SrikarBharadwajR/Project-Tachometer/README.md

# Project-Tachometer
Instrument which is used for measuring rotations per minute of a rotating object.
