SrikarBharadwajR/Project-Tachometer/BOM with Price.ods

Sl. No. | Name | Quantity | Price | Link | Distributor Part Number
1 | PCB Printing
2 | 1.3” OLED Display | 1 | 367 | https://robu.in/product/1-3-inch-i2c-iic-oled-4-pin-lcd-module-4pin-with-vcc-gnd-blue/ | 617729
3 | IR Emitter and Receiver LEDs | 1 | - | - | -
4 | 10k Trimmer Potentiometer | 1 | 89 | https://robu.in/product/3296w-10k-ohm-trimpot-trimmer-potentiometer-pack-of-5/ | 611196
5 | 100R resistor | 1 | 1 | - | -
6 | Male and Female Headers | - | - | - | -
7 | 1uF Capacitor | 4 | 23.25 | https://www.digikey.in/en/products/detail/murata-electronics/GCG21BR71H105KA01L/16033470 | 490-GCG21BR71H105KA01LCT-ND
8 | 10uF Capacitor | 3 | 18.26 | https://www.digikey.in/en/products/detail/murata-electronics/GRM21BR61E106KA73L/2334874 | 490-5523-1-ND
9 | 0.1uF Capacitor | 6 | 19.92 | https://www.digikey.in/en/products/detail/murata-electronics/GCJ21BR72A104KA01K/11618560 | 490-GCJ21BR72A104KA01KCT-ND
10 | 33pF Capacitor | 2 | 71.4 | https://www.digikey.in/en/products/detail/murata-electronics/GQM2195C2E330FB12D/11618474 | 490-GQM2195C2E330FB12DCT-ND
11 | 10k Resistor | 6 | 11.62 | https://www.digikey.in/en/products/detail/rohm-semiconductor/ESR03EZPF1002/1983429 | RHM10KADCT-ND
12 | 1.5k Resistor | 3 | 11.62 | https://www.digikey.in/en/products/detail/rohm-semiconductor/ESR03EZPF1501/1983433 | RHM1.50KADCT-ND
13 | 500R Resistor | 1 | 10.79 | https://www.digikey.in/en/products/detail/rohm-semiconductor/ESR03EZPJ511/1762734 | RHM510DCT-ND
14 | 0R Resistor | 1 | 8.3 | https://www.digikey.in/en/products/detail/rohm-semiconductor/SFR03EZPJ000/9771856 | 511-1823-1-ND
15 | STM32F103C8T6 | 1 | 532.99 | https://www.digikey.in/en/products/detail/stmicroelectronics/STM32F103C8T6TR/2122442 | 497-17666-1-ND
16 | Slide Switch | 1 | 88.83 | https://www.digikey.in/en/products/detail/c-k/PCM12SMTR/1640112 | 401-2016-1-ND
17 | OP-Amp LMV321WG | 1 | 40.68 | https://www.digikey.in/en/products/detail/diodes-incorporated/LMV321WG-7/2182582 | LMV321WG-7DICT-ND
18 | Indication Yellow LED | 1 | 25.74 | https://www.digikey.in/en/products/detail/dialight/5988070107F/1291269 | 350-2035-1-ND
19 | AMS1117 3.3v regulator | 1 | 31.55 | https://www.digikey.in/en/products/detail/diodes-incorporated/AZ1117H-3-3TRE1/4471000 | AZ1117H-3.3TRE1DICT-ND
20 | Crystal Oscillator | 1 | 32.38 | https://www.digikey.in/en/products/detail/fox-electronics/FC4SDCBMF8-0-T1/1024602 | 631-1010-1-ND
21 | Toggle Switch | 3 | 19.92 | https://www.digikey.in/en/products/detail/cui-devices/TS09-63-25-WT-160-SMT-TR/15839066 | 2223-TS09-63-25-WT-160-SMT-TRCT-ND
22 | 120R Ferrite Bead | 1 | 15.77 | https://www.digikey.in/en/products/detail/laird-signal-integrity-products/MI0603M121R-10/806614 | 240-2375-1-ND
23 | Micro USB | 1 | 58.11 | https://www.digikey.in/en/products/detail/gct/USB3076-30-A/9859635 | 2073-USB3076-30-ACT-ND
 | TOTAL AMOUNT (in Rs.) = |  | 1876.58
