SrikarBharadwajR/Project-Tachometer/PCB Design/Tachometer/Tachometer.kicad_pcb

## KiCad design PCB Design/Tachometer/Tachometer.kicad_pcb (2023-09-17)

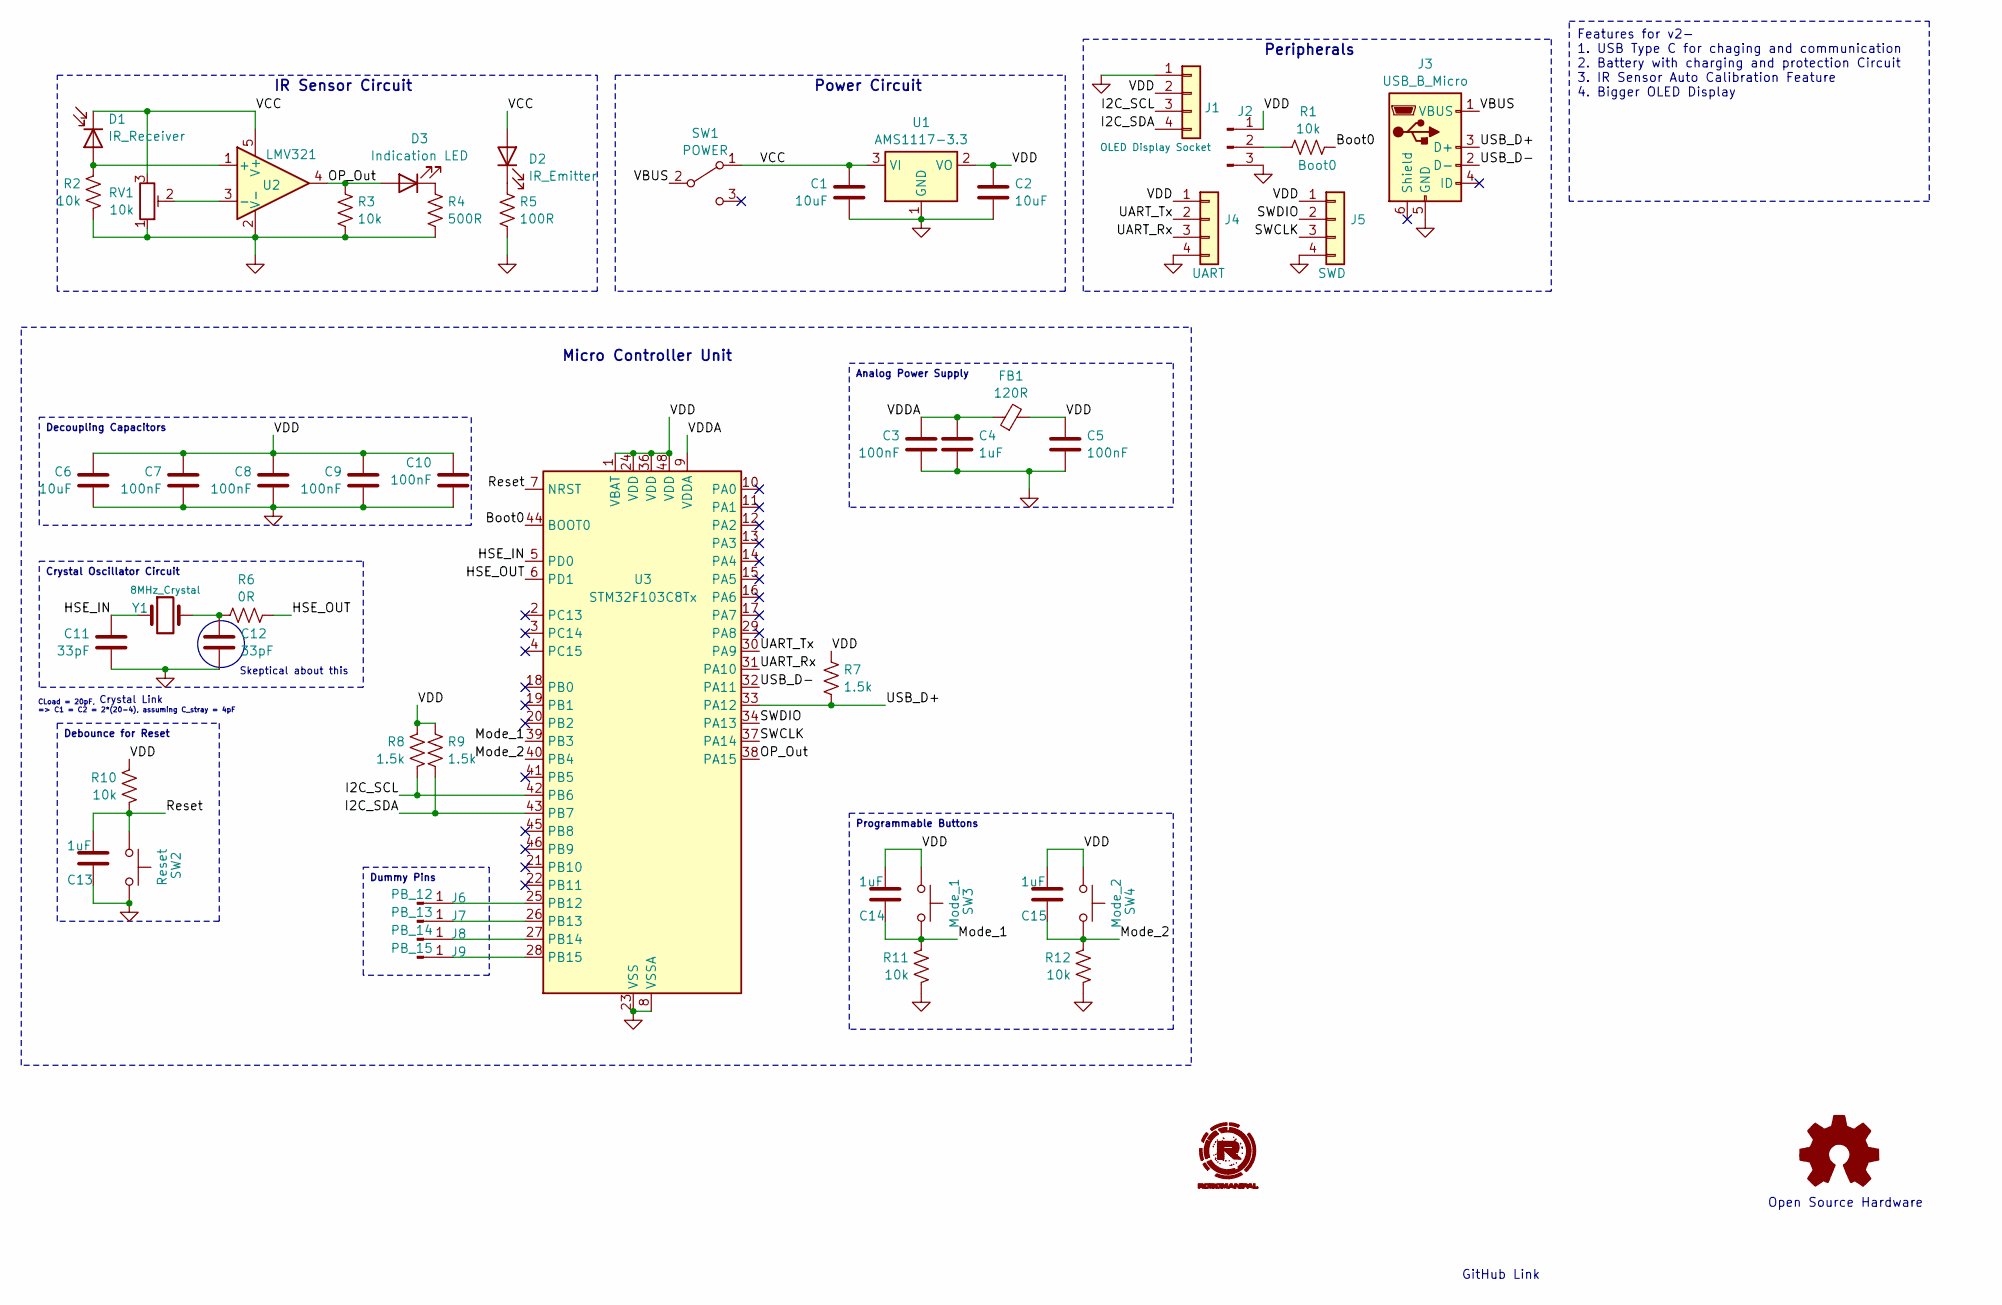
[picture p1: schematic Tachometer.kicad_sch, Project Tachometer]

Parts:
C1, C2, C6: 10uF; C_0805_2012Metric_Pad1.18x1.45mm_HandSolder
C3, C5, C7, C8, C9, C10: 100nF; C_0805_2012Metric_Pad1.18x1.45mm_HandSolder
C4, C13, C14, C15: 1uF; C_0805_2012Metric_Pad1.18x1.45mm_HandSolder
C11, C12: 33pF; C_0805_2012Metric_Pad1.18x1.45mm_HandSolder
D1: IR_Receiver; LED_5mm_Radial
D2: IR_Emitter; LED_5mm_Radial
D3: Indication LED; LED_0603_1608Metric_Pad1.05x0.95mm_HandSolder
FB1: 120R; L_0603_1608Metric_Pad1.05x0.95mm_HandSolder
J1: OLED Display Socket; PinSocket_1x04_P2.54mm_Vertical
J2: Boot0; PinHeader_1x03_P2.54mm_Vertical
J3: USB_B_Micro; USB_Micro-B_GCT_USB3076-30-A
J4: UART; PinHeader_1x04_P2.54mm_Vertical
J5: SWD; PinHeader_1x04_P2.54mm_Vertical
J6: PB_12; SolderWirePad_1x01_SMD_1x2mm
J7: PB_13; SolderWirePad_1x01_SMD_1x2mm
J8: PB_14; SolderWirePad_1x01_SMD_1x2mm
J9: PB_15; SolderWirePad_1x01_SMD_1x2mm
R1, R2, R3, R10, R11, R12: 10k; R_0603_1608Metric_Pad0.98x0.95mm_HandSolder
R4: 500R; R_0603_1608Metric_Pad0.98x0.95mm_HandSolder
R5: 100R; R_Axial_DIN0204_L3.6mm_D1.6mm_P5.08mm_Horizontal
R6: 0R; R_0603_1608Metric_Pad0.98x0.95mm_HandSolder
R7, R8, R9: 1.5k; R_0603_1608Metric_Pad0.98x0.95mm_HandSolder
RV1: 10k; Potentiometer_Bourns_3296W_Vertical
SW1: POWER; SW_SPDT_PCM12
SW2: Reset; SW_TS09-63-25-WT-160-SMT-TR
SW3: Mode_1; SW_TS09-63-25-WT-160-SMT-TR
SW4: Mode_2; SW_TS09-63-25-WT-160-SMT-TR
U1: AMS1117-3.3; SOT-223-3_TabPin2
U2: LMV321; SOT25
U3: STM32F103C8Tx; LQFP-48_7x7mm_P0.5mm
Y1: 8MHz_Crystal; Crystal_SMD_HC49-SD

Connections:
/Boot0: R1.2, U3.44 (BOOT0)
/HSE_IN: C11.1, U3.5 (PD0), Y1.1
/HSE_OUT: R6.2, U3.6 (PD1)
/I2C_SCL: J1.3, R8.1, U3.42 (PB6)
/I2C_SDA: J1.4, R9.1, U3.43 (PB7)
/Mode_1: C14.1, R11.2, SW3.2, U3.39 (PB3)
/Mode_2: C15.1, R12.2, SW4.2, U3.40 (PB4)
/OP_Out: D3.2 (A), R3.1, U2.4, U3.38 (PA15)
/Reset: C13.2, R10.1, SW2.1, U3.7 (NRST)
/SWCLK: J5.3, U3.37 (PA14)
/SWDIO: J5.2, U3.34 (PA13)
/UART_Rx: J4.3, U3.31 (PA10)
/UART_Tx: J4.2, U3.30 (PA9)
/USB_D+: J3.3 (D+), R7.1, U3.33 (PA12)
/USB_D-: J3.2 (D-), U3.32 (PA11)
/VBUS: J3.1 (VBUS), SW1.2 (B)
/VCC: C1.1, D1.1 (K), D2.2 (A), RV1.3, SW1.1 (A), U1.3 (VI), U2.5 (V+)
/VDD: C2.1, C5.1, C6.1, C7.1, C8.1, C9.1, C10.1, C14.2, C15.2, FB1.2, J1.2, J2.1, J4.1, J5.1, R7.2, R8.2, R9.2, R10.2, SW3.1, SW4.1, U1.2 (VO), U3.1 (VBAT), U3.24 (VDD), U3.36 (VDD), U3.48 (VDD)
/VDDA: C3.1, C4.1, FB1.1, U3.9 (VDDA)
GND: C1.2, C2.2, C3.2, C4.2, C5.2, C6.2, C7.2, C8.2, C9.2, C10.2, C11.2, C12.2, C13.1, J1.1, J2.3, J3.5 (GND), J4.4, J5.4, R2.2, R3.2, R4.2, R5.2, R11.1, R12.1, RV1.1, SW2.2, U1.1 (GND), U2.2 (V-), U3.8 (VSSA), U3.23 (VSS), U3.35 (VSS), U3.47 (VSS)
unnamed: C12.1, R6.1, Y1.2
unnamed: D1.2 (A), R2.1, U2.1 (+)
unnamed: D2.1 (K), R5.1
unnamed: D3.1 (K), R4.1
unnamed: J2.2, R1.1
unnamed: J6.1, U3.25 (PB12)
unnamed: J7.1, U3.26 (PB13)
unnamed: J8.1, U3.27 (PB14)
unnamed: J9.1, U3.28 (PB15)
unnamed: RV1.2, U2.3 (-)

Notes on the sheet:
Analog Power Supply
Decoupling Capacitors
Crystal Oscillator Circuit
Dummy Pins
Programmable Buttons
Debounce for Reset
Features for v2- 1. USB Type C for chaging and communication 2. Battery with charging and protection Circuit 3. IR Sensor Auto Calibration Feature 4. Bigger OLED Display
Peripherals
Skeptical about this
Power Circuit
CLoad = 20pF, => C1 = C2 = 2*(20-4), assuming C_stray = 4pF
Micro Controller Unit
GitHub Link
Crystal Link
Open Source Hardware
IR Sensor Circuit

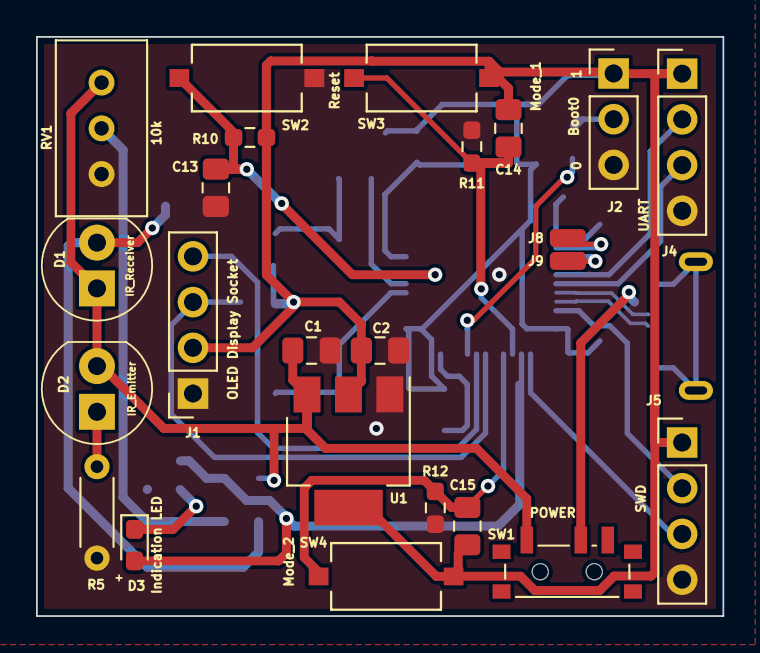
[picture p2: board Tachometer.kicad_pcb from above]

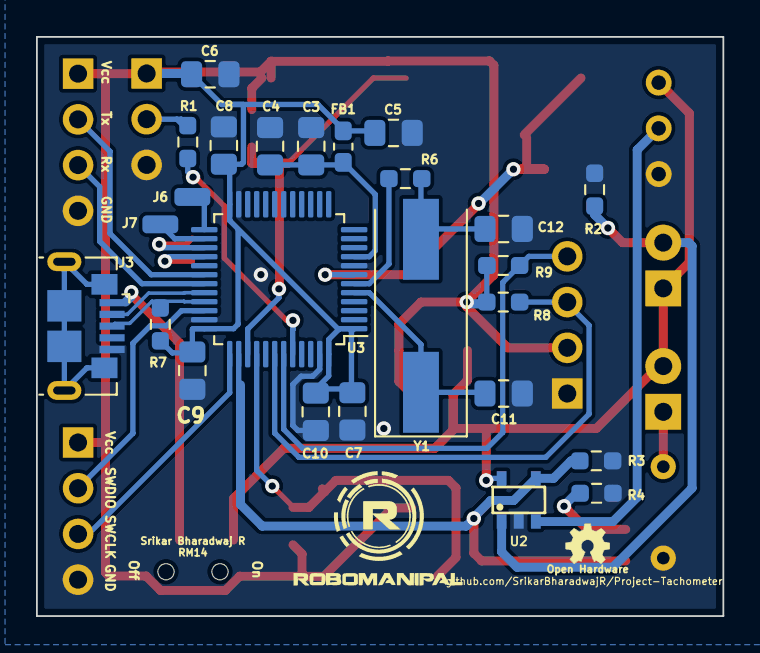
[picture p3: board Tachometer.kicad_pcb from below]

Board: 2 copper layers, 38.1 x 32.2 mm, 50 parts (26 on the bottom side), 30 nets.

Other parts of the board:
Ref**: Val**; OSHW_Logo_2.5mm
