SrikarBharadwajR/Project-Tachometer/Firmware/Core/Src/main.c

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
/* Includes ------------------------------------------------------------------*/
#include "main.h"
#include "usb_device.h"

/* USER CODE BEGIN Includes */
#include "string.h"
#include "fonts.h"
#include "ssd1306.h"
#include "usbd_cdc_if.h"
#include "stdio.h"
/* USER CODE END Includes */

/* USER CODE BEGIN PD */
#define IDLE 0
#define DONE 1
#define F_CLK 72000000UL
/* USER CODE END PD */

/* USER CODE BEGIN PM */
volatile uint8_t state = IDLE;
volatile uint32_t T1 = 0;
volatile uint32_t T2 = 0;
volatile uint32_t ticks = 0;
volatile uint32_t TIM4_OVC = 0;
/* USER CODE END PM */

I2C_HandleTypeDef hi2c1;

TIM_HandleTypeDef htim2;

UART_HandleTypeDef huart2;

void SystemClock_Config(void);
static void MX_GPIO_Init(void);
static void MX_I2C1_Init(void);
static void MX_USART2_UART_Init(void);
static void MX_TIM2_Init(void);
/* USER CODE BEGIN 0 */

void HAL_TIM_IC_CaptureCallback(TIM_HandleTypeDef *htim) {
	if (state == IDLE) {
		T1 = TIM2->CCR1;
		TIM4_OVC = 0;
		state = DONE;
	} else if (state == DONE) {
		T2 = TIM2->CCR1;
		ticks = (T2 + (TIM4_OVC * 65536)) - T1;
		state = IDLE;
	}
}

void HAL_TIM_PeriodElapsedCallback(TIM_HandleTypeDef *htim) {
	TIM4_OVC++;
}

/* USER CODE END 0 */

/**
  * @brief  The application entry point.
  * @retval int
  */
int main(void)
{
  /* MCU Configuration--------------------------------------------------------*/

  /* Reset of all peripherals, Initializes the Flash interface and the Systick. */
  HAL_Init();

  /* Configure the system clock */
  SystemClock_Config();

  /* Initialize all configured peripherals */
  MX_GPIO_Init();
  MX_I2C1_Init();
  MX_USART2_UART_Init();
  MX_USB_DEVICE_Init();
  MX_TIM2_Init();
  /* USER CODE BEGIN 2 */

	HAL_TIM_Base_Start_IT(&htim2);
	HAL_TIM_IC_Start_IT(&htim2, TIM_CHANNEL_1);
	SSD1306_Init();
  /* USER CODE END 2 */

  /* Infinite loop */
  /* USER CODE BEGIN WHILE */
	while (1) {
		char message[15];
		float RPM = ((F_CLK / (float) ticks)) * 60.0;
		if (RPM <= 100000) {
			sprintf(message, "%.3f", RPM);
			SSD1306_GotoXY(0, 0);
			SSD1306_Puts(message, &Font_16x26, 1);
			SSD1306_GotoXY(90, 40);
			SSD1306_Puts("RPM", &Font_11x18, 1);
		} else {
			message[0] = 'N';
			message[1] = 'o';
			message[2] = ' ';
			message[3] = 'R';
			message[4] = 'P';
			message[5] = 'M';
			message[6] = '\0';
			SSD1306_GotoXY(0, 0);
			SSD1306_Puts(message, &Font_16x26, 1);
		}
		SSD1306_UpdateScreen();
		ticks = 1.0;
		CDC_Transmit_FS((uint8_t *)strcat(message,"\n"), strlen(message));
		HAL_Delay(1000);
		SSD1306_Clear();
    /* USER CODE END WHILE */

    /* USER CODE BEGIN 3 */
	}
  /* USER CODE END 3 */
}

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
