SrikarBharadwajR/Project-Tachometer/Firmware/RM_Tachometer_Receiver.ioc

Mcu.UserName=STM32F103C8Tx
PA11.Signal=USB_DM
PA12.Signal=USB_DP
PA13.Signal=SYS_JTMS-SWDIO
PA14.Signal=SYS_JTCK-SWCLK
PB9.Signal=S_TIM4_CH4
PD0-OSC_IN.Signal=RCC_OSC_IN
PD1-OSC_OUT.Signal=RCC_OSC_OUT
